Jaystonian/VIC20-2587KB-Memory-Expander/Images/back.png

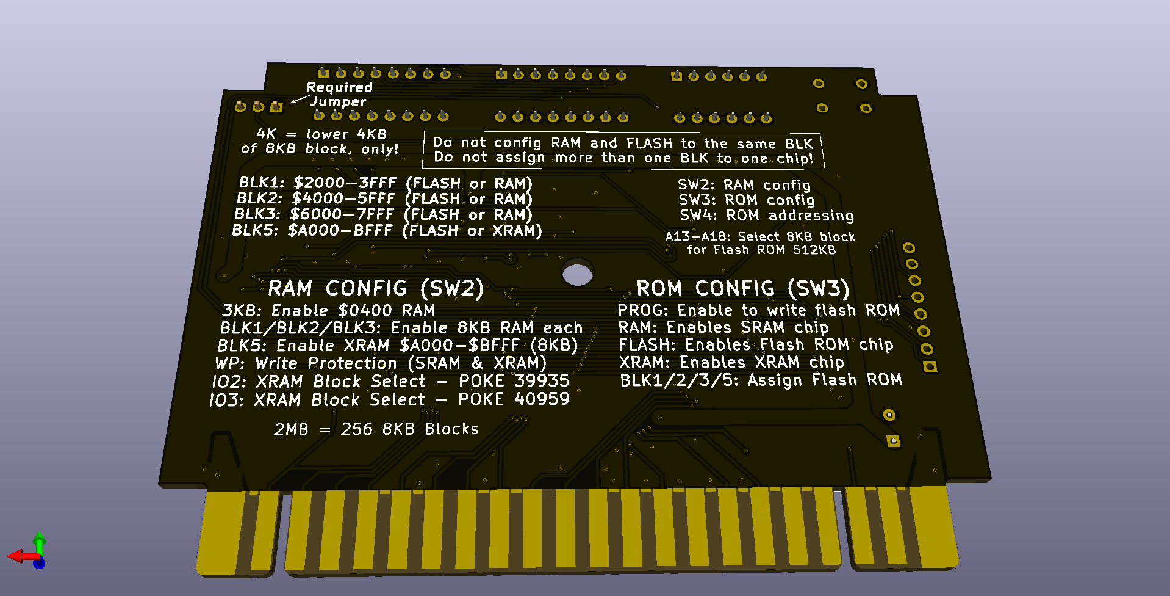
Images/back.png
