Jaystonian/VIC20-2587KB-Memory-Expander/Images/front.png

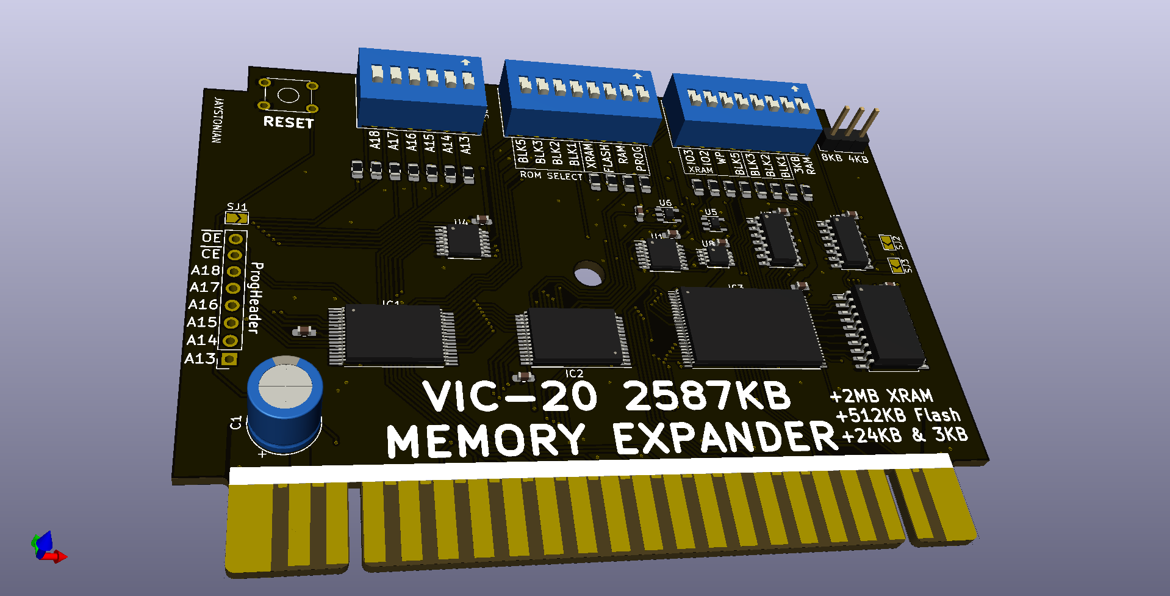
Images/front.png
