Jaystonian/VIC20-2587KB-Memory-Expander/README.md

# VIC20-2587KB-Memory-Expander
An REU for the Commodore VIC-20 with 512KB reprogrammable Flash memory, 35KB RAM Expansion and 2MB paged memory in 8KB blocks
