Jaystonian/VIC20-2587KB-Memory-Expander/PDF/VIC20 2587KB Memory Expander.pdf

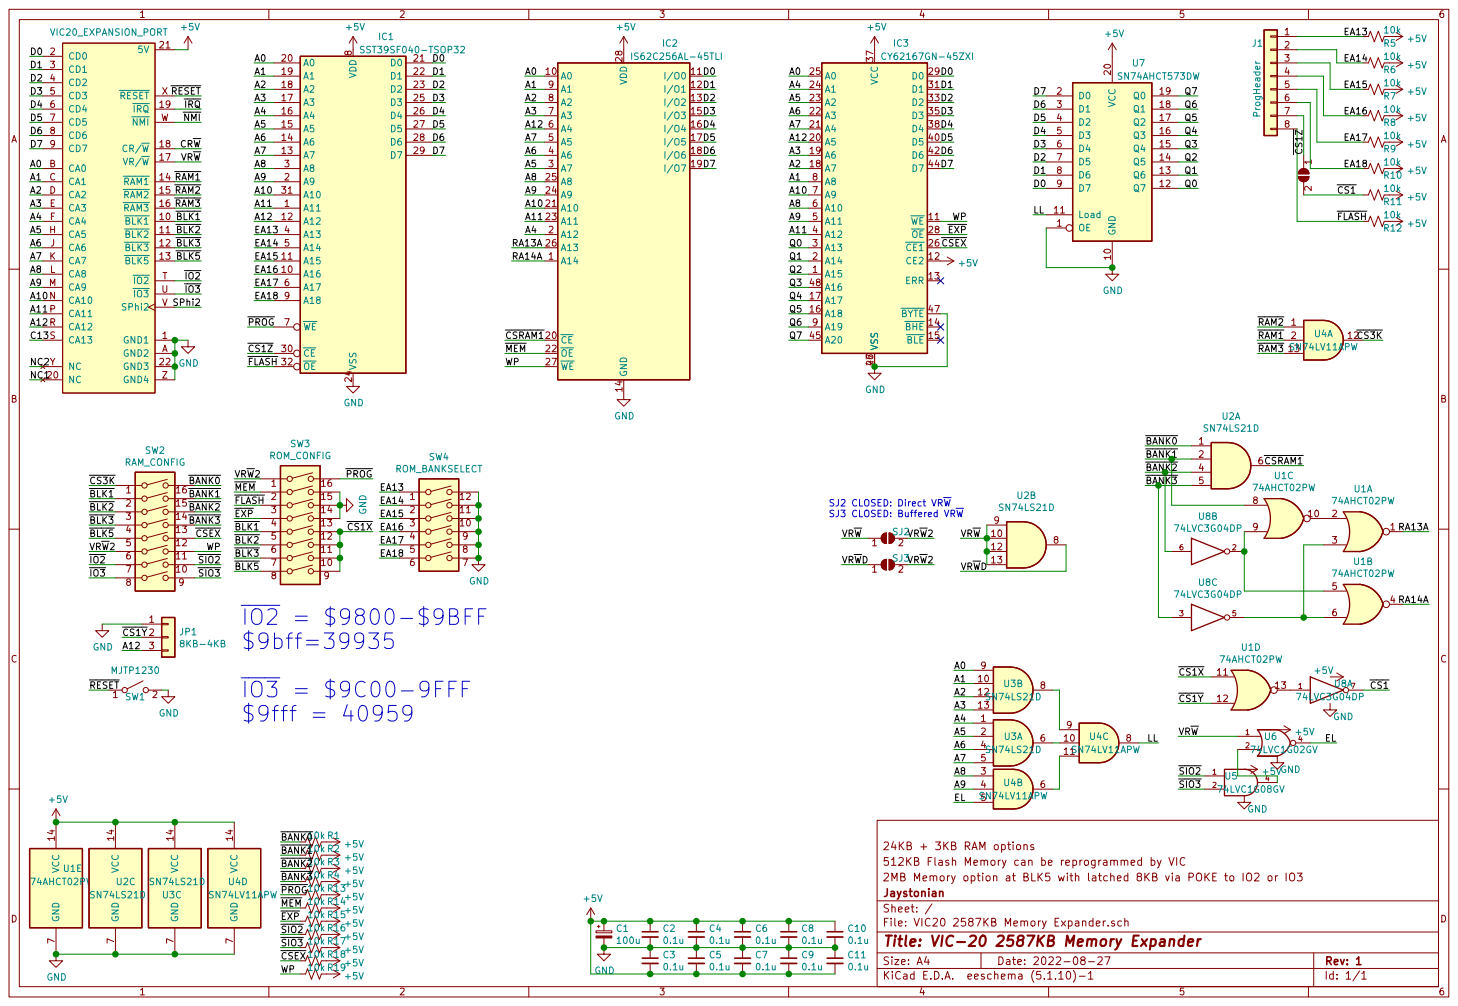
[picture p3: page 1]

24KB + 3KB RAM options C11
512KB Flash Memory can be reprogrammed by VIC
2MB Memory option at BLK5 with latched 8KB via POKE to IO2 or IO3
File: VIC20 2587KB Memory Expander.sch Sheet: / Jaystonian

Id: 1/1 Title: VIC-20 2587KB Memory Expander
