Jaystonian/VIC20-2587KB-Memory-Expander/KiCad/VIC20 2587KB Memory Expander.kicad_pcb

## KiCad design KiCad/VIC20 2587KB Memory Expander.kicad_pcb (2022-08-28)

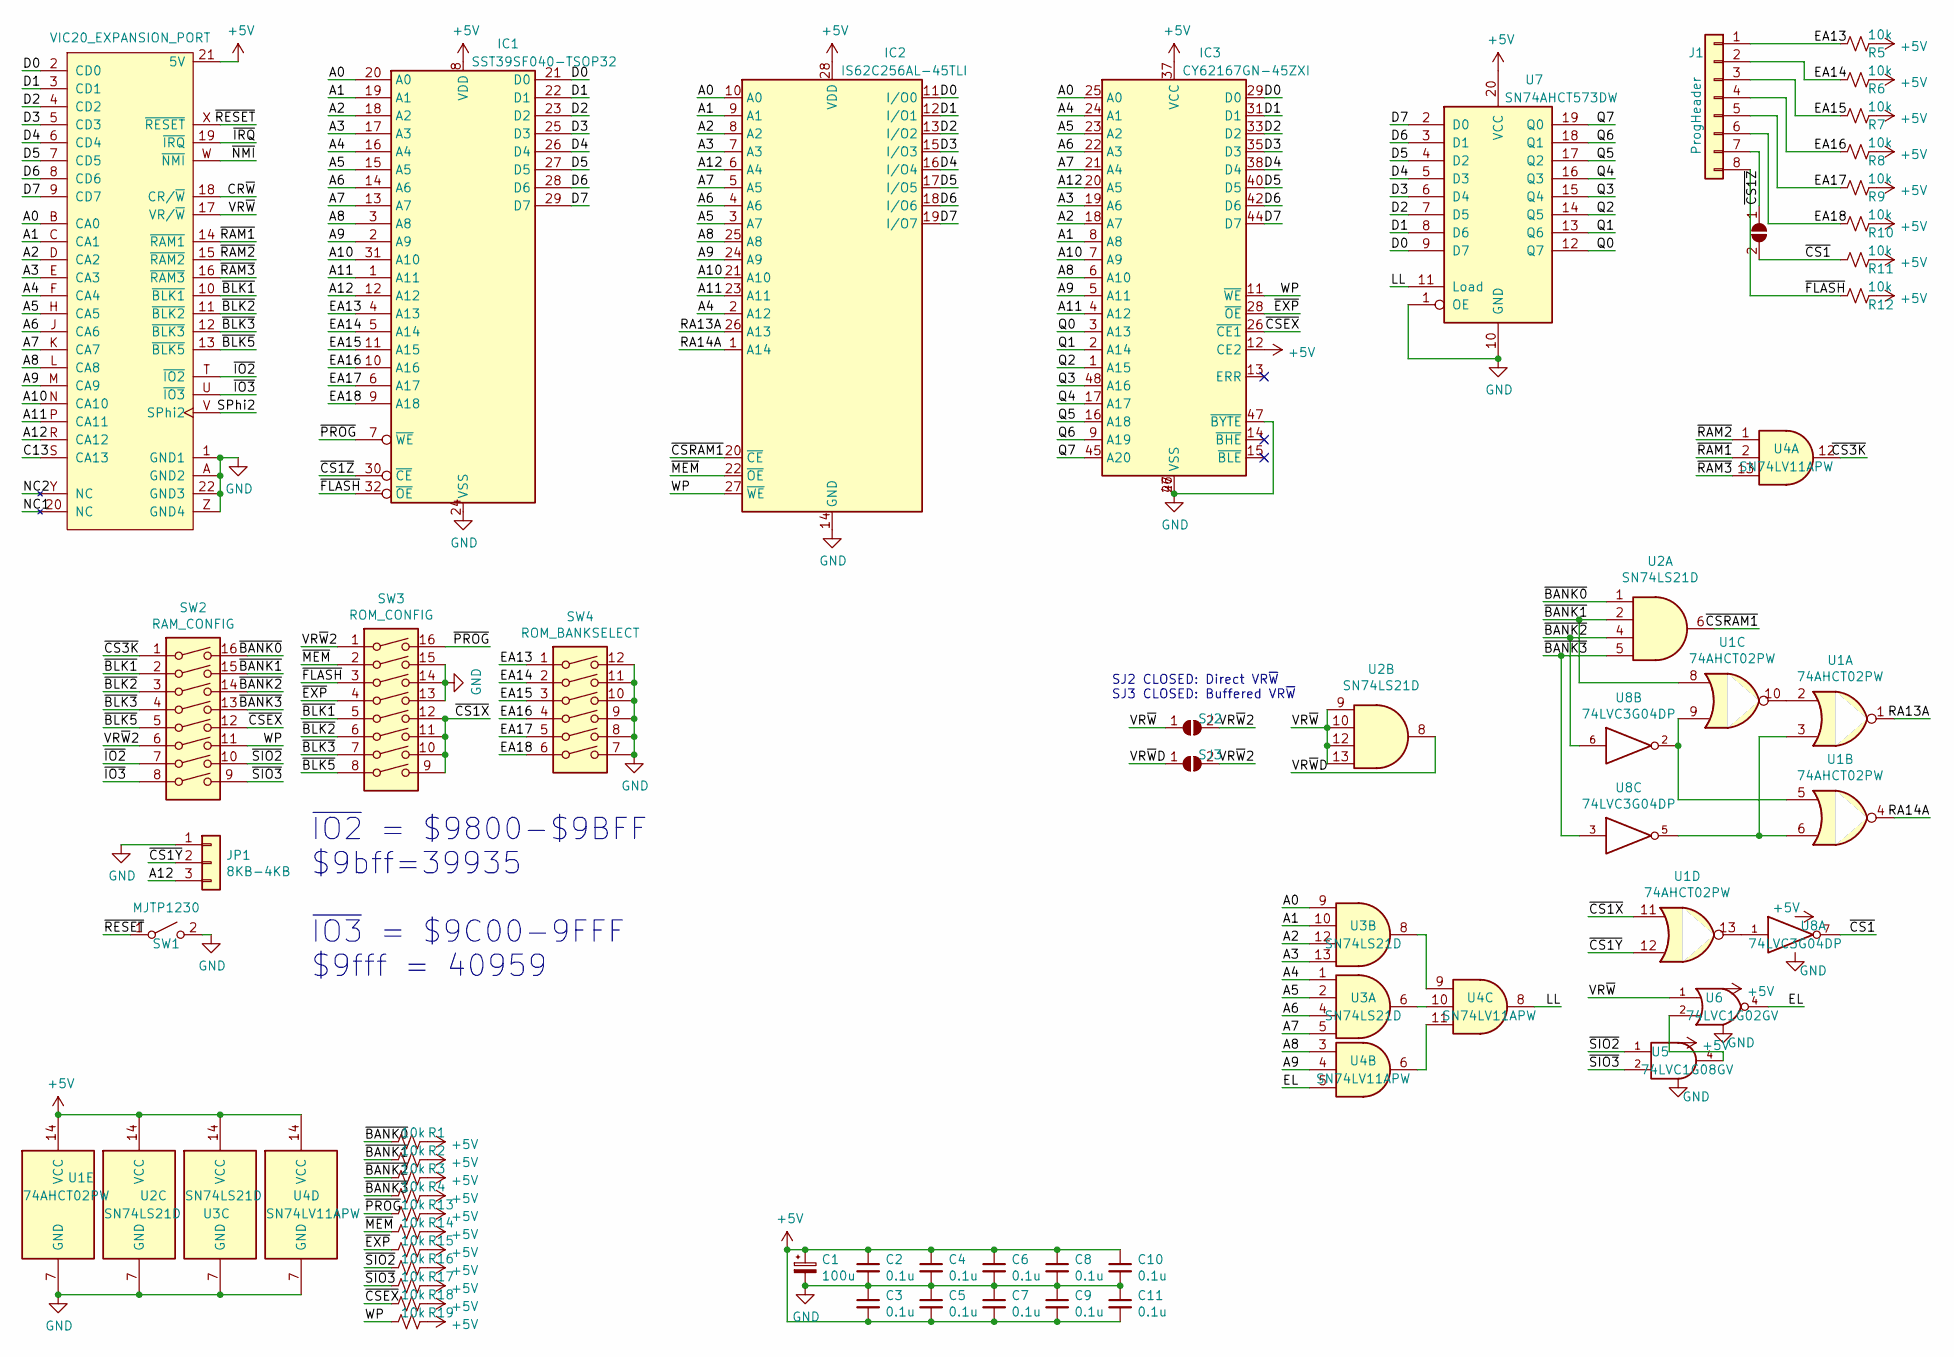
[picture p4: schematic VIC20 2587KB Memory Expander.sch, VIC-20 2587KB Memory Expander]

Parts:
C1: 100u; CP_Radial_D8.0mm_P3.50mm
C2, C3, C4, C5, C6, C7, C8, C9, C10, C11: 0.1u; C_0603_1608Metric_Pad1.05x0.95mm_HandSolder
IC1: SST39SF040-TSOP32; TSOP-32_14x8mm_P0.5mm
IC2: IS62C256AL-45TLI
IC3: CY62167GN-45ZXI; TSOP-I-48_18.4x12mm_P0.5mm
J1: ProgHeader; PinSocket_1x08_P2.54mm_Vertical
JP1: 8KB-4KB; PinHeader_1x03_P2.54mm_Vertical
R1, R2, R3, R4, R5, R6, R7, R8, R9, R10, R11, R12, R13, R14, R15, R16, R17, R18, R19: 10k; R_0805_2012Metric_Pad1.15x1.40mm_HandSolder
SJ1, SJ2, SJ3: SolderJumper_2_Open; SolderJumper-2_P1.3mm_Open_TrianglePad1.0x1.5mm
SW1: MJTP1230; SW_PUSH_6mm_H8mm
SW2: RAM_CONFIG; SW_DIP_SPSTx08_Slide_9.78x22.5mm_W7.62mm_P2.54mm
SW3: ROM_CONFIG; SW_DIP_SPSTx08_Slide_9.78x22.5mm_W7.62mm_P2.54mm
SW4: ROM_BANKSELECT; SW_DIP_SPSTx06_Slide_9.78x17.42mm_W7.62mm_P2.54mm
U1: 74AHCT02PW; TSSOP-14_4.4x5mm_P0.65mm
U2, U3: SN74LS21D; SOIC-14_3.9x8.7mm_P1.27mm
U4: SN74LV11APW; TSSOP-14_4.4x5mm_P0.65mm
U5: 74LVC1G08GV; SOT-753
U6: 74LVC1G02GV; SOT-753
U7: SN74AHCT573DW; SOIC-20W_7.5x12.8mm_P1.27mm
U8: 74LVC3G04DP; TSSOP-8_3x3mm_P0.65mm
X1: VIC20_EXPANSION_PORT; VIC20_EXPANSION_CARD_sven

Connections:
+5V: C1.1, C2.1, C3.2, C4.1, C5.2, C6.1, C7.2, C8.1, C9.2, C10.1, C11.2, IC1.8 (VDD), IC2.28 (VDD), IC3.12 (CE2), IC3.37 (VCC), R1.1, R2.1, R3.1, R4.1, R5.1, R6.1, R7.1, R8.1, R9.1, R10.1, R11.1, R12.1, R13.1, R14.1, R15.1, R16.1, R17.1, R18.1, R19.1, U1.14 (VCC), U2.14 (VCC), U3.14 (VCC), U4.14 (VCC), U5.5 (VCC), U6.5 (VCC), U7.20 (VCC), U8.8 (VCC), X1.21 (5V)
/A0: IC1.20 (A0), IC2.10 (A0), IC3.25 (A0), U3.9, X1.B (CA0)
/A1: IC1.19 (A1), IC2.9 (A1), IC3.8 (A8), U3.10, X1.C (CA1)
/A2: IC1.18 (A2), IC2.8 (A2), IC3.18 (A7), U3.12, X1.D (CA2)
/A3: IC1.17 (A3), IC2.7 (A3), IC3.19 (A6), U3.13, X1.E (CA3)
/A4: IC1.16 (A4), IC2.2 (A12), IC3.24 (A1), U3.1, X1.F (CA4)
/A5: IC1.15 (A5), IC2.3 (A7), IC3.23 (A2), U3.2, X1.H (CA5)
/A6: IC1.14 (A6), IC2.4 (A6), IC3.22 (A3), U3.4, X1.J (CA6)
/A7: IC1.13 (A7), IC2.5 (A5), IC3.21 (A4), U3.5, X1.K (CA7)
/A8: IC1.3 (A8), IC2.25 (A8), IC3.6 (A10), U4.3, X1.L (CA8)
/A9: IC1.2 (A9), IC2.24 (A9), IC3.5 (A11), U4.4, X1.M (CA9)
/A10: IC1.31 (A10), IC2.21 (A10), IC3.7 (A9), X1.N (CA10)
/A11: IC1.1 (A11), IC2.23 (A11), IC3.4 (A12), X1.P (CA11)
/A12: IC1.12 (A12), IC2.6 (A4), IC3.20 (A5), JP1.3, X1.R (CA12)
/C13: X1.S (CA13)
/CR~W: X1.18 (CR/~W~)
/D0: IC1.21 (D0), IC2.11 (I/O0), IC3.29 (D0), U7.9 (D7), X1.2 (CD0)
/D1: IC1.22 (D1), IC2.12 (I/O1), IC3.31 (D1), U7.8 (D6), X1.3 (CD1)
/D2: IC1.23 (D2), IC2.13 (I/O2), IC3.33 (D2), U7.7 (D5), X1.4 (CD2)
/D3: IC1.25 (D3), IC2.15 (I/O3), IC3.35 (D3), U7.6 (D4), X1.5 (CD3)
/D4: IC1.26 (D4), IC2.16 (I/O4), IC3.38 (D4), U7.5 (D3), X1.6 (CD4)
/D5: IC1.27 (D5), IC2.17 (I/O5), IC3.40 (D5), U7.4 (D2), X1.7 (CD5)
/D6: IC1.28 (D6), IC2.18 (I/O6), IC3.42 (D6), U7.3 (D1), X1.8 (CD6)
/D7: IC1.29 (D7), IC2.19 (I/O7), IC3.44 (D7), U7.2 (D0), X1.9 (CD7)
/EA13: IC1.4 (A13), J1.1, R5.2, SW4.1
/EA14: IC1.5 (A14), J1.2, R6.2, SW4.2
/EA15: IC1.11 (A15), J1.3, R7.2, SW4.3
/EA16: IC1.10 (A16), J1.4, R8.2, SW4.4
/EA17: IC1.6 (A17), J1.5, R9.2, SW4.5
/EA18: IC1.9 (A18), J1.6, R10.2, SW4.6
/EL: U4.5, U6.4
/LL: U4.8, U7.11 (Load)
/NC1: X1.20 (NC)
/NC2: X1.Y (NC)
/Q0: IC3.3 (A13), U7.12 (Q7)
/Q1: IC3.2 (A14), U7.13 (Q6)
/Q2: IC3.1 (A15), U7.14 (Q5)
/Q3: IC3.48 (A16), U7.15 (Q4)
/Q4: IC3.17 (A17), U7.16 (Q3)
/Q5: IC3.16 (A18), U7.17 (Q2)
/Q6: IC3.9 (A19), U7.18 (Q1)
/Q7: IC3.45 (A20), U7.19 (Q0)
/RA13A: IC2.26 (A13), U1.1
/RA14A: IC2.1 (A14), U1.4
/SPhi2: X1.V (SPhi2)
/VR~W: SJ2.1 (A), U2.9, U2.10, U2.12, U2.13, U6.1, X1.17 (VR/~W~)
/VR~W~2: SJ2.2 (B), SJ3.2 (B), SW2.6, SW3.1
/VR~W~D: SJ3.1 (A), U2.8
/WP: IC2.27 (~WE), IC3.11 (~WE~), R19.2, SW2.11
/~BANK0: R1.2, SW2.16, U2.1
/~BANK1: R2.2, SW2.15, U1.8, U2.2
/~BANK2: R3.2, SW2.14, U2.4, U8.6
/~BANK3: R4.2, SW2.13, U2.5, U8.3
/~BLK1: SW2.2, SW3.5, X1.10 (~BLK1~)
/~BLK2: SW2.3, SW3.6, X1.11 (~BLK2~)
/~BLK3: SW2.4, SW3.7, X1.12 (~BLK3~)
/~BLK5: SW2.5, SW3.8, X1.13 (~BLK5~)
/~CS1: R11.2, SJ1.2 (B), U8.7
/~CS1X: SW3.9, SW3.10, SW3.11, SW3.12, U1.11
/~CS1Y: JP1.2, U1.12
/~CS1Z: IC1.30 (~CE), J1.7, SJ1.1 (A)
/~CS3K: SW2.1, U4.12
/~CSEX: IC3.26 (~CE1~), R18.2, SW2.12
/~CSRAM1: IC2.20 (~CE), U2.6
/~EXP: IC3.28 (~OE~), R15.2, SW3.4
/~FLASH: IC1.32 (~OE), J1.8, R12.2, SW3.3
/~IO2: SW2.7, X1.T (~IO2)
/~IO3: SW2.8, X1.U (~IO3)
/~IRQ: X1.19 (~IRQ~)
/~MEM: IC2.22 (~OE), R14.2, SW3.2
/~NMI: X1.W (~NMI~)
/~PROG: IC1.7 (~WE), R13.2, SW3.16
/~RAM1: U4.2, X1.14 (~RAM1~)
/~RAM2: U4.1, X1.15 (~RAM2~)
/~RAM3: U4.13, X1.16 (~RAM3~)
/~RESET: SW1.1 (A), X1.X (~RESET~)
/~SIO2: R16.2, SW2.10, U5.1
/~SIO3: R17.2, SW2.9, U5.2
GND: C1.2, C2.2, C3.1, C4.2, C5.1, C6.2, C7.1, C8.2, C9.1, C10.2, C11.1, IC1.24 (VSS), IC2.14 (GND), IC3.27 (VSS), IC3.46 (VSS), IC3.47 (~BYTE), JP1.1, SW1.2 (B), SW3.13, SW3.14, SW3.15, SW4.7, SW4.8, SW4.9, SW4.10, SW4.11, SW4.12, U1.7 (GND), U2.7 (GND), U3.7 (GND), U4.7 (GND), U5.3 (GND), U6.3 (GND), U7.1 (OE), U7.10 (GND), U8.4 (GND), X1.1 (GND1), X1.22 (GND3), X1.A (GND2), X1.Z (GND4)
unnamed: U1.3, U1.6, U8.5
unnamed: U1.5, U1.9, U8.2
unnamed: U1.2, U1.10
unnamed: U1.13, U8.1
unnamed: U3.6, U4.10
unnamed: U3.8, U4.9
unnamed: U4.6, U4.11
unnamed: U5.4, U6.2

Notes on the sheet:
~IO2~ = $9800-$9BFF $9bff=39935 ~IO3~ = $9C00-9FFF $9fff = 40959
SJ2 CLOSED: Direct VR~W~ SJ3 CLOSED: Buffered VR~W~

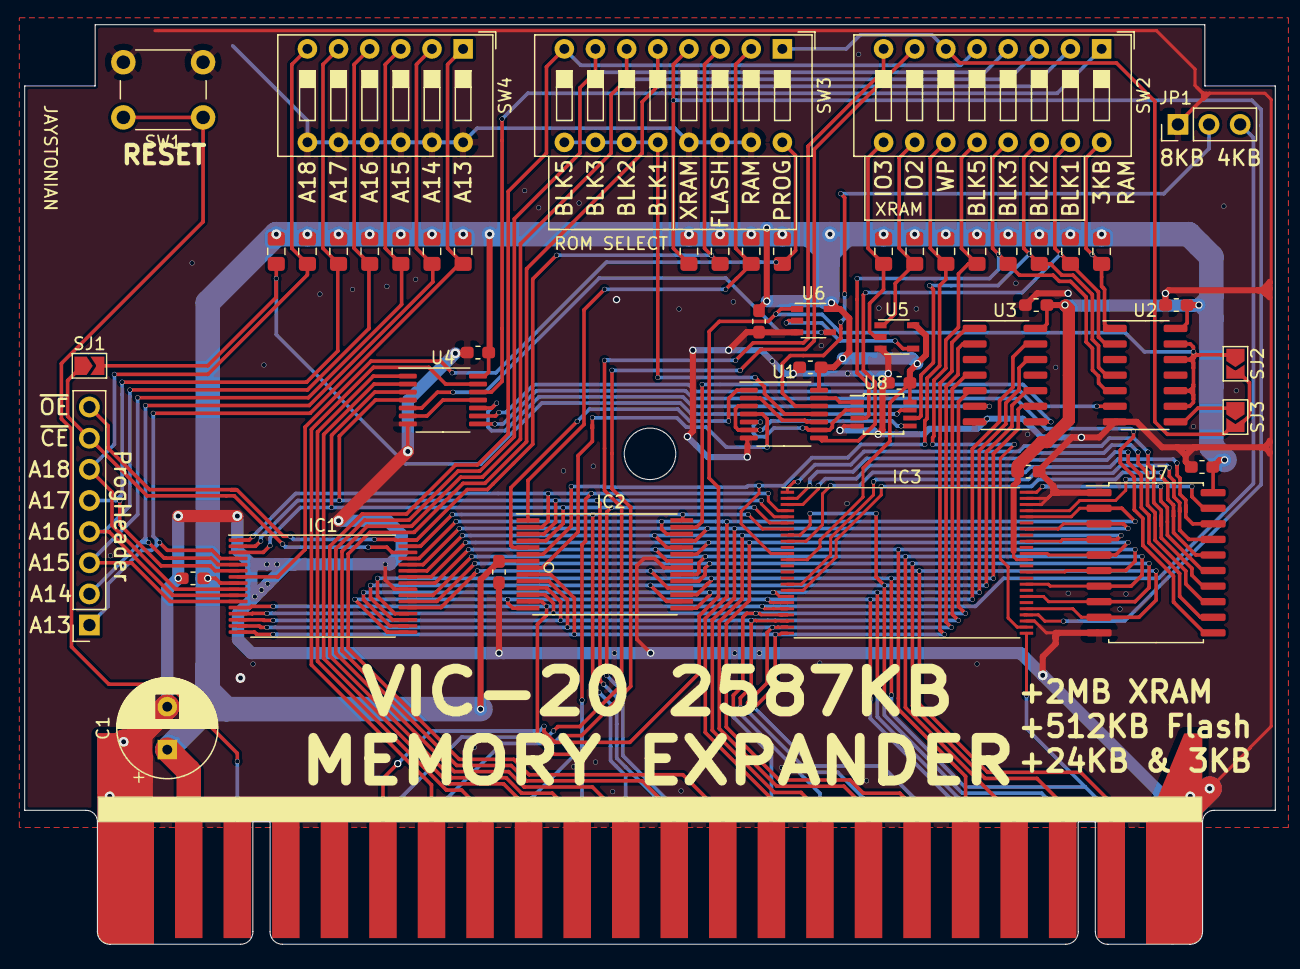
[picture p5: board VIC20 2587KB Memory Expander.kicad_pcb from above]

Board: 2 copper layers, 102.0 x 75.0 mm, 51 parts (0 on the bottom side), 80 nets.
